rubberhelix/MultiSNICS_Interlock/Resources/Interlock Panel.png

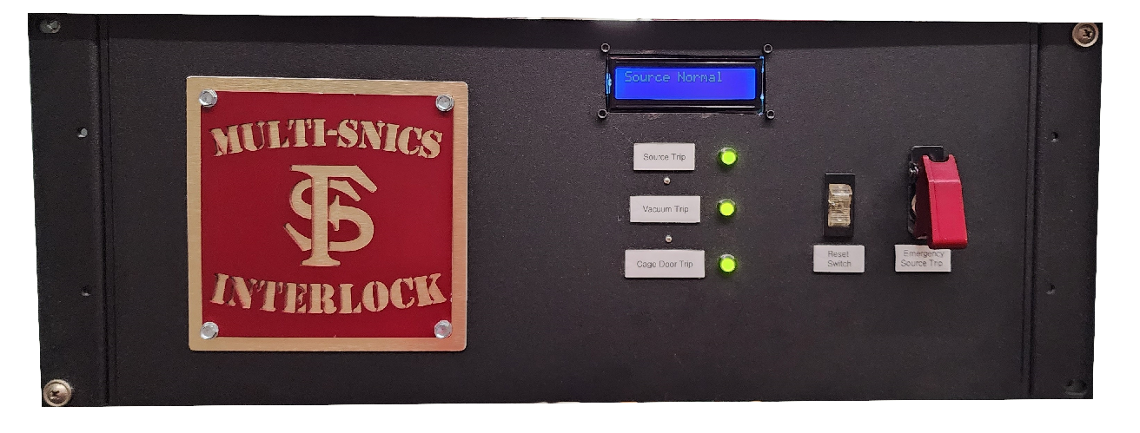
Resources/Interlock Panel.png
