rubberhelix/MultiSNICS_Interlock/Resources/Multi-SNICS Interlock User Manual Rev1.pdf

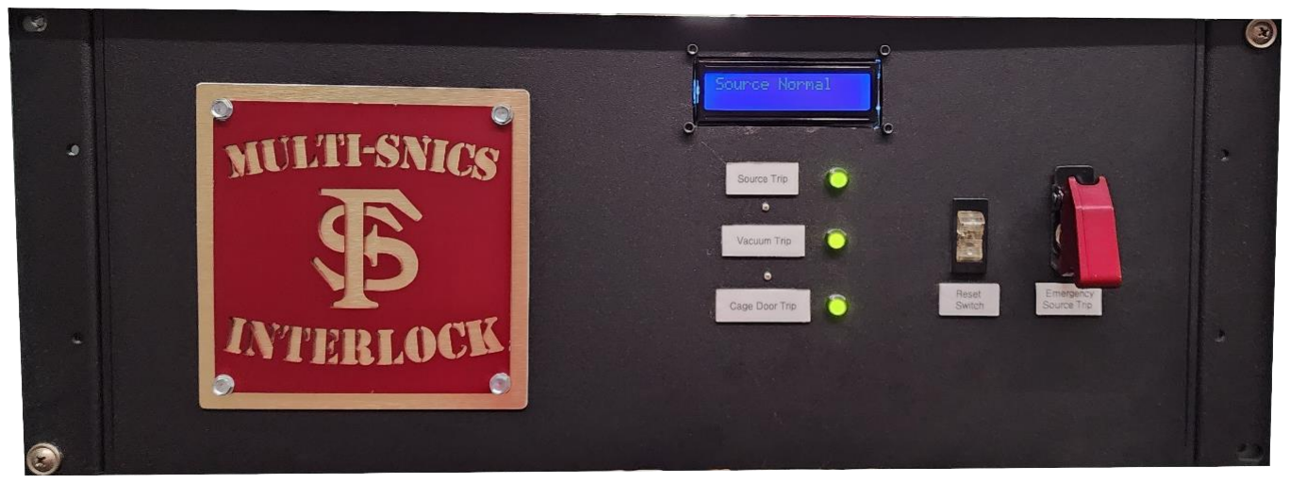
[picture p2: figure]

# MULTI-SNICS INTERLOCK

## USER MANUAL

WRITTEN BY: JONAH GIBBONS
JOHN D. FOX LABORATORY

### REVISION 1

MULTI-SNICS INTERLOCK | P A G E | 1

## SAFETY NOTICE

Please take a moment to read and understand the following user manual before using or reconfiguring this Interlock System.
The following general safety precautions must be observed during all phases of operation, service, and repair of this instrument. Failure to comply with these precautions or each subsystem manufacture’s intended use can result in damage, personnel injury or even death.
The protective features of this product may be impaired if it is used in a manner not specified in the operation instructions.
1. Operation by Trained Personnel:
The Interlock System must be operated and configured by qualified and trained personnel who are familiar with the electrical and ion accelerator systems.
2. Lockout/Tagout Procedures:
Before servicing the Interlock System, follow all applicable lockout/tagout procedures to ensure that controlled equipment is safely de-energized and secured to prevent inadvertent state changes that could cause damage, injury, or death.
3. Proper Cable Routing:
High voltage differences between the ground, mid-, and high potential areas can cause arcing electrical sparks. Ensure proper isolation and insulation provides adequate separation of conducting materials.
4. Regular Maintenance:
Regularly inspect the Interlock System for malfunctions. A basic set of test procedures is provided in this manual, but it is recommended to establish a general procedure for testing the Interlock System prior to, during, and after operating the ion accelerator.
5. Emergency Procedures:
Establish and communicate emergency shutdown procedures in case of any system failure or malfunction. Ensure that all personnel are aware of these procedures.
6. Restricted Access:
Restrict access and authority of the Interlock System's controls and components to authorized personnel only.
7. Environmental Considerations:
Do not expose the system to extreme temperatures, moisture, or corrosive environments. Adverse conditions can affect the system's performance.

8. Hazard Identification:
Clearly label all Interlock System control points and components to help users easily identify and understand their function.
9. Training:
Ensure that all personnel responsible for operating the ion accelerator or the Interlock System receive proper training on its operation and safety procedures.
10. Emergency Shutdown:
In case of an emergency, the Interlock System may be overridden or bypassed if required for safety reasons. Ensure that this process is well-documented and supervised. Operating the system in a bypassed state for periods extending beyond emergency conditions defeats the integrity and purpose of using an Interlock System and abiding by its established procedures. Bypassed conditions should be announced at every proceeding staff briefing to be sure the situation is not overlooked or forgotten until it is permanently resolved, and the bypass condition no longer exists.
11. High-power Danger:
The Interlock System controls several high-power supplies that operate the ion source. These power supplies can cause extreme injury or death. Beware of the risk involved and consult with laboratory staff to ensure the risks are always mitigated.
12. Radioactive Hazard:
The multi-SNICS is configured to use tritium cathodes. Tritium is radioactive and presents a health risk if you are exposed. Be sure you are briefed on the status of tritium inside the ion source and aware of the proper handling procedures to avoid a leak or release of tritium. If it is suspected that tritium has escaped containment. Immediately evacuate the room and report your concern to lab personnel.

### Table of Contents

# Overview

The Multi-SNICS has several very high voltage power supplies, a high vacuum chamber, several types of pumps, and is designed to work with tritium embedded cathodes. Tritium is a radioactive isotope of hydrogen that poses a significant health risk if ingested, inhaled, or absorbed into the body. To operate the Multi-SNICS safely, a comprehensive safety plan is required. Part of the plan is an Interlock System that acts as a fail-safe mechanism, actively monitoring key parameters such as closure of the cage doors surrounding the source, leaking tritium detection, vacuum pressure, building power, coolant flow, and smoke detection. In the event of deviations from safe operating conditions, the Interlock System initiates automatic shutdown procedures, preventing potential harm to personnel, the environment, and the equipment itself.

# Equipment

The Interlock System is based on a P1AM ProductivityOpen PLC controller. It has industrial grade ratings to endure harsh environments. There are a lot of options for modules that snap together and communicate on a Modbus. The expandability of this platform makes it a good choice for this application because it can evolve to meet new needs in the future. [Appendix E]

## ProductivityOpen Controller

The Interlock System uses the following P1AM series modules:

- P1AM-100 – Main CPU [Appendix F]
- P1-01DC – Modbus Power Supply [Appendix G]
- P1AM-ETH – Ethernet Shield [Appendix H]
- P1AM-GPIO – General Purpose Input/Output Shield [Appendix I]
- P1-16ND3 – 16 Discrete Inputs [Appendix J]
- P1-08TRS (2x) – 8 Relay Outputs [Appendix K]
- P1-04ADL-2 – 4 Analog Inputs [Appendix L]

## Main Power Supply

There is a Mean Well USA Inc AC/DC converter that converts 120 VAC to 24 VDC and is used to power everything in the rack-mounted enclosure.

## Fiber Optic Isolation

The ion source has two high-voltage regions that must be electrically isolated to prevent a short circuit. The regions are each referred to as the high and mid-potential regions respective of their relative voltage potential. Each region has a fiber optic link to relay contact closures or analog signals between the Interlock System and the sensors and control devices. [Appendix M,N]

### -Interlock System Enclosure (Ground Potential):

- 2x Bidirectional contact closure fiber transceivers
- Analog voltage signal fiber receiver

### -Mid-potential Area:

- Bidirectional contact closure fiber transceiver
- Analog voltage signal fiber transmitter

### -High-potential Area:

- Bidirectional contact closure fiber transceiver

## LCD Screen

The screen is a commonly used 1602 LCD module with a built in HD44780 controller. It can display 2 lines of up to 16 characters. It receives display commands from the P1AM-GPIO shield.
*** It requires 5 VDC power but must have a common ground with the P1AM Modbus. Accessing the Modbus common was difficult and required modifying the GPIO shield by opening the case and soldering a wire to a through-via that connected to the Modbus common.***

## Sensors

- Cage door contacts
- Fume hood flow switch
- Vacuum gauge threshold relays
- Vacuum gauge analog output [Appendix O]
- Tritium detector threshold relay
- Tritium detector analog output
- Building power monitor relay
- Coolant flow switches
- Smoke detector [Appendix Q]
- Titanium sublimation pump analog output [Appendix P]

# Specifications

Interlock System Enclosure | 120 VAC
Enclosure DC Power Supply | 24 VDC
Bidirectional Fiber Transceivers | 120 VAC
Fiber Mode | Single mode
Analog Signal Fiber Transmitter/Receiver | 24 VDC
Analog Signal Voltage Range | 0-10 VDC
Fiber Mode | Multi mode
P1-16ND3 Module Input Rating | 12-24 VDC sink/source
P1-04ADL-2 Analog Module | 0-10 VDC signals
Resolution | 13-bit
Cage Door Contacts | Normally Closed
Fume Hood Flow Switch | Normally Closed
Vacuum Condition Relays | Normally Open
Analog Signal | 0-10 VDC
Tritium Monitor Relay | Normally Closed
Analog Signal | 0-10 VDC
Building Power Monitor Relay | Normally Closed
Coolant Flow Switches | Normally Closed
Smoke Detector | Normally Open
Sublimation Pump Analog Signal | 0-10 VDC

# Firmware

There is drag-and-drop, ladder logic, style programming software called Productivity Blocks, but it is also compatible with the Arduino development environment and can be programmed using C++. There is a micro-USB port on the P1AM-100 controller that is used to upload firmware and read serial output.

## File Structure

### interlock.ino

This is the main file for the software. It contains boot up procedures, main routines and any diagnostic functions for development and testing.

### states.ino

This file contains the settings for the output conditions for different states.

### tasks.ino

This file contains the main functions for checking the inputs, changing states, and updating interfaces.

### web.ino

This file contains the html code for the webpage served by the ethernet module. The webpage shows the state and conditions of the inputs as well as the analog values.

### diagnostics.ino

This file contains diagnostic functions and statements that can be copied into the main file or called from here if you un-comment them.

### map.h

This file contains the names for the signals and maps the ports and pins to convenient variable names (in# or out#). Only change the comments for the signals to match what's connected to the interlock for reference.

### config.h

This file contains the settings for the ethernet module, GPIO pins for the LCD screen, the states, the data structure, the normal conditions for the inputs, the alarm priority they are associated with, the Modbus modules, and the text strings used for the LCD display.

# Diagnostics

The primary diagnostic tool for the Interlock System is the serial output which can be read by connecting a laptop to the micro-USB port on the P1AM-100. There is also a switch next to the port which enables a periodic report of the interlock state and any of the inputs that are tripped. When the controller first boots up, the heartbeat LED flashes while it waits for initialization to finish. Then it checks the Modbus to verify all the modules are reporting. Every full cycle of the controller loop has a heartbeat of three flashes of the LED on the P1AM-100. There is also a watchdog timer which will automatically reset the controller if it takes longer than 5 seconds to complete a loop.

There is a diagnostics file in the firmware package which has some tools for diagnosing problems. In the file is a library called ArduinoTrace which has two useful functions for diagnosing firmware problems line by line. Reading the code and the comment lines can give a better clue as to the expected behavior of the Interlock System. Using the TRACE() and DUMP() functions provided by the ArduinoTrace library allow you to put markers in the code and dump variable data to the serial output so it is more easy to follow the program’s behavior.

The ethernet shield has a webpage server that provides a graphical display of the system state. It is set to automatically refresh every few seconds. This was designed to be a secondary display to provide information remotely to any computer which is connected to the lab’s local area network.

# Sample Test Procedure

A test procedure should be thorough and standardized. Starting with a list of the sensors, one method would be to test each of the sensors in order to verify that they are reporting the appropriate alarm. Verify that when they are tripped, the Interlock System responds with a buzzer alarm, an LED showing the trouble state, and the LCD showing the proper message. Then inducing a lower-level cage door trouble condition followed by a vacuum system trouble condition and a source trouble condition to demonstrate that the Interlock System escalates to higher trouble conditions when additional sensors are tripped. After each alarm, verify that the appropriate systems have been disabled and locked out in response to the trouble condition.

Cage door contacts | Test by opening the cage doors
Fume hood flow switch | Test by turning off the breaker in the electrical closet two stories above the lab
Vacuum gauge threshold relays | Test by changing the vacuum threshold level or by running the sublimation pump
Vacuum gauge analog output | Run the sublimation pump or cross check with other gauges nearby in the line
Tritium detector threshold relay | Change the calibration zero or use a test method prescribed in the manual
Tritium detector analog output | Change the calibration zero or use a test method prescribed in the manual
Building power monitor relay | Open the breaker located in the rack cabinet under the Interlock System enclosure
Coolant flow switches | Turn off the coolant pump
Smoke detector | Press the test button located on the smoke detector
Titanium sublimation pump analog output | Turn on the pump and cross check the current shown on the controller with the current measured by the analog output

## Appendix A: LED and Buzzer Wiring Diagram

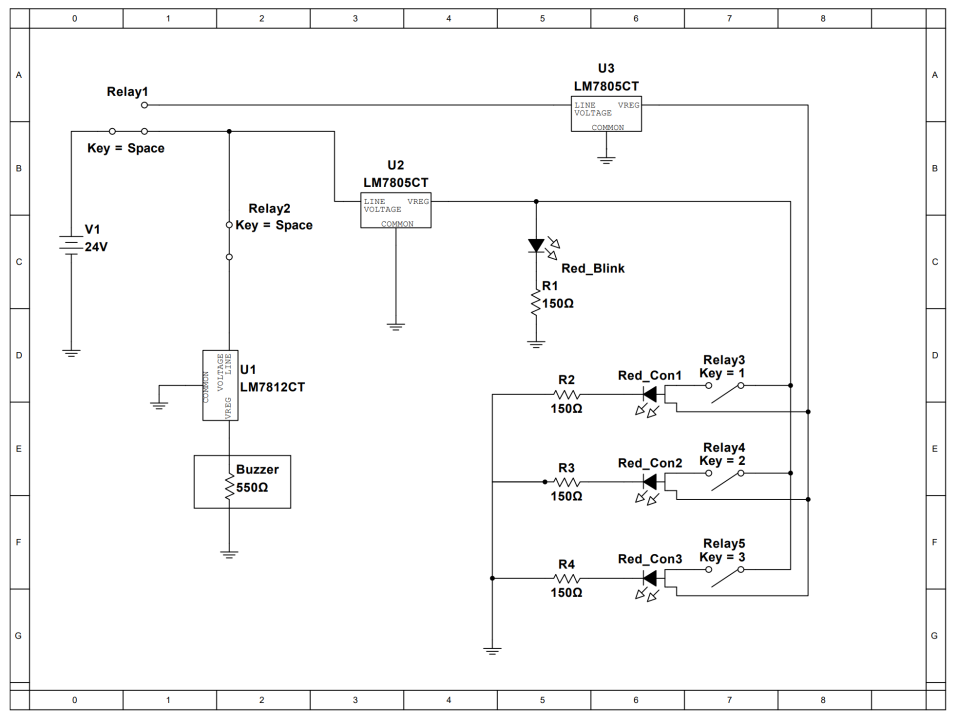
[picture p3: figure]

## Appendix B: Multi-SNICS Diagram

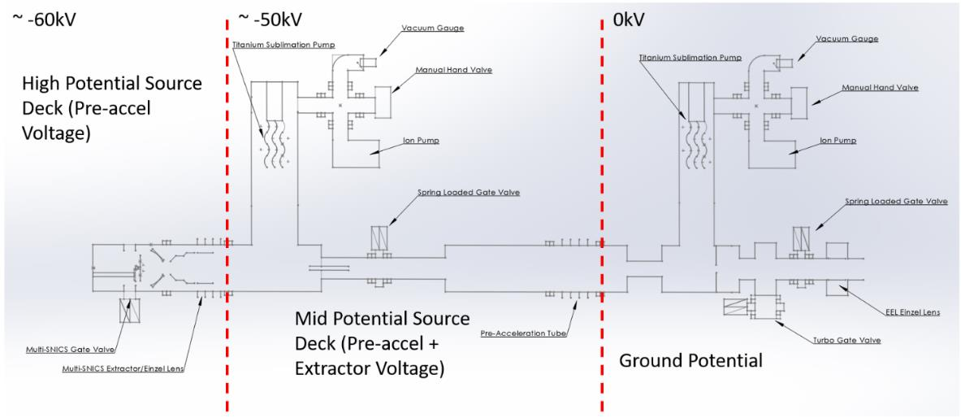
[picture p4: figure]

# Appendix C: Port Map

| Logic Port | Name | Wire Terminal | Normal State
Input: | 1.1 | Reset Button | - | NO
| 1.2 | Emergency Interlock Switch | - | NC
| 1.3 | Cage Door Sensor | Main 1 | NC
| 1.4 | Fume Hood Flow Switch | Main 2 | NC
| 1.5 | Vacuum Condition 2 - Ground | Main 3 | NO
| 1.6 | Tritium Monitor Relay | Main 4 | NC
| 1.7 | (UNUSED) | - | -
| 1.8 | Building Power Failure Relay | Main 6 | NC
| 1.9 | Coolant Flow Switch 2 - Ground | Main 7 | NC
| 1.10 | Vacuum Condition 1 - Mid Potential | Fiber K9 - Mid | NO
| 1.11 | (UNUSED) | - | -
| 1.12 | Coolant Flow Switch 1 - Mid Potential | Fiber K9 - High | NC
| 1.13 | Smoke Detector - High Potential | Fiber K10 - High | NO
| 1.14 | (UNUSED) | - | -
| 1.15 | (UNUSED) | - | -
| 1.16 | (UNUSED) | - | -
(analog) | Tritium Sniffer - Ground | Main 17 & 18
(analog) | Vacuum Gauge - Mid Potential | Fiber - Mid
(analog) | Sublimation Pump - Mid Potential | Fiber - Mid
Output: | 2.1 | Green and Flashing Red LEDs | -
| 2.2 | Buzzer | -
| 2.3 | Red LED Trouble 1 | -
| 2.4 | Red LED Trouble 2 | -
| 2.5 | Red LED Trouble 3 | -
| 2.6 | Pre-accelerator Power Supply | Main 9 & 10
| 2.7 | Gate Valve - Ground | Main 11 & 12
| 2.8 | Gate Valve - Mid Potential | Fiber K1 - Mid
3.1 | | -
3.2 | | -
3.3 | | -
3.4 | | -
3.5 | | -
3.6 | High-volt Power Supplies | Fiber K1 - High
3.7 | Boiler | Fiber K2 - High
3.8 | Ionizer | Fiber K3 - High

## Appendix D: Trouble Modes

| Low Cage Door Trip | Medium Vacuum Trip | High Source Trip
| (Trouble 1) | (Trouble 2) | (Trouble 3)
Outputs | Pre-accelerator Supply Off | Pre-Accelerator Supply Off | Pre-Accelerator Supply Off
| Other High-Power Supplies Off | Other High-Power Supplies Off | Other High-Power Supplies Off
| | Both Gate Valves Closed | Close Both Gate Valves
| | Ionizer | Boiler
| | | Ionizer
Inputs | Cage Door Contact | Vacuum Condition (Gnd) | Emergency Source Trip Switch
| | Vacuum Condition (Mid) | Fume Hood Flow Switch
| | | Tritium Monitor Relay
| | | Building Power Failure Relay
| | | Smoke Detector

## Appendix E: Interlock System Enclosure

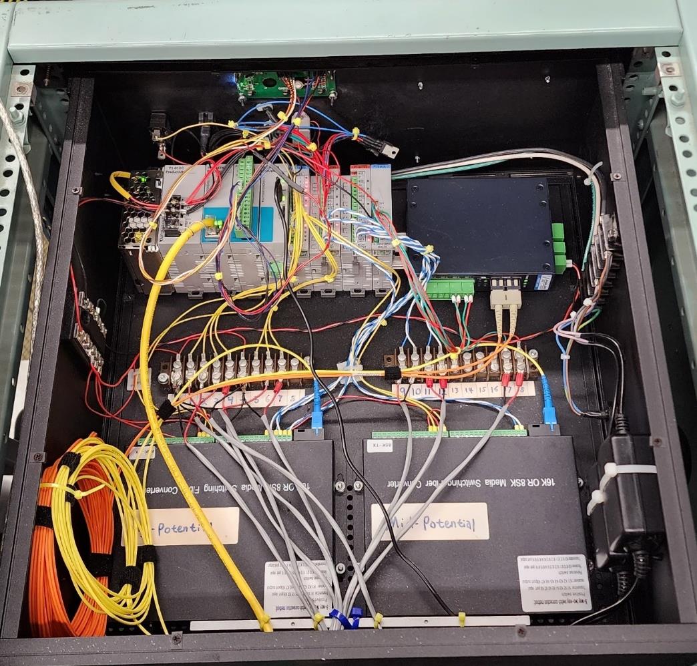
[picture p5: figure]

## Appendix F: P1AM-100 Product Description

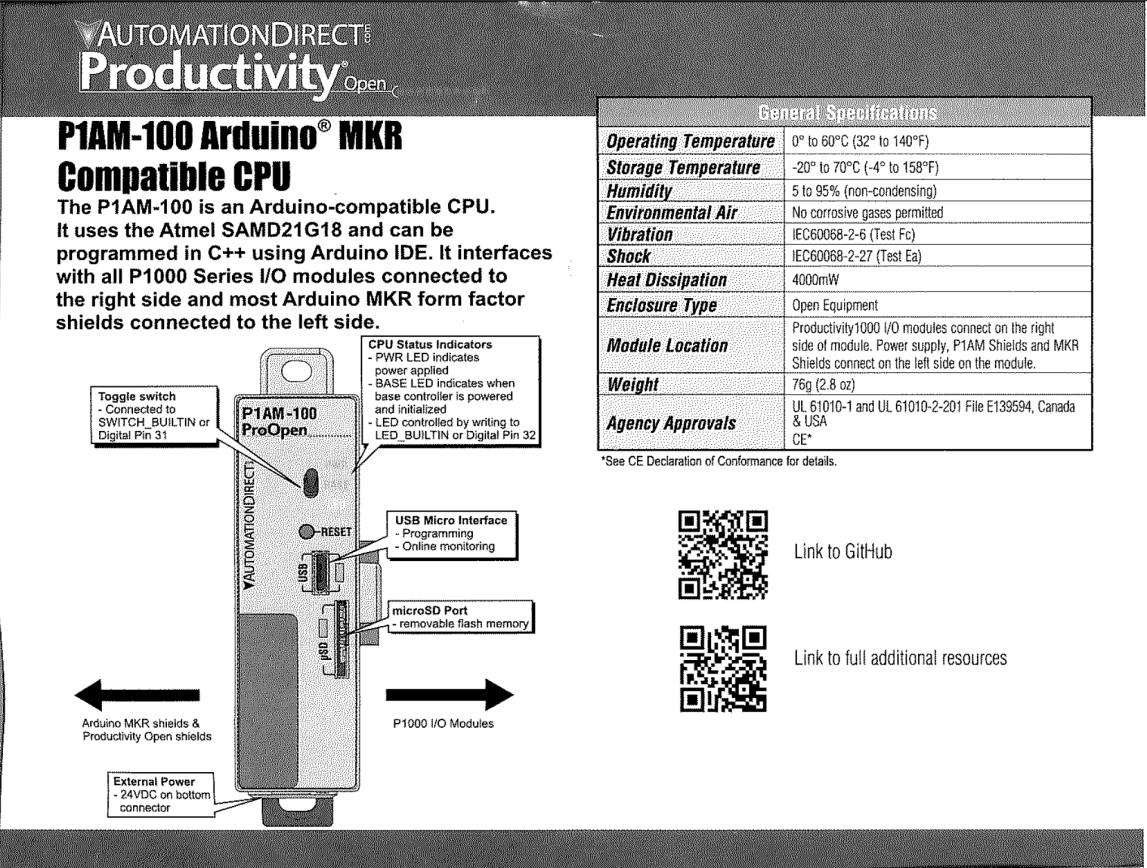
[picture p6: figure]

## Appendix G: P1-01DC Product Description

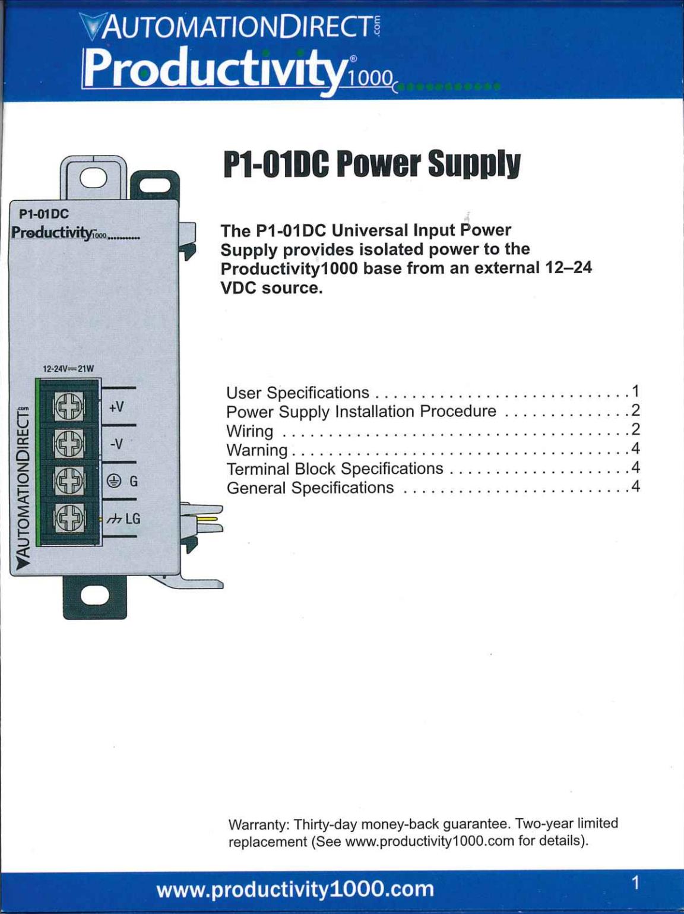
[picture p7: figure]

## Appendix H: P1AM-ETH Product Description

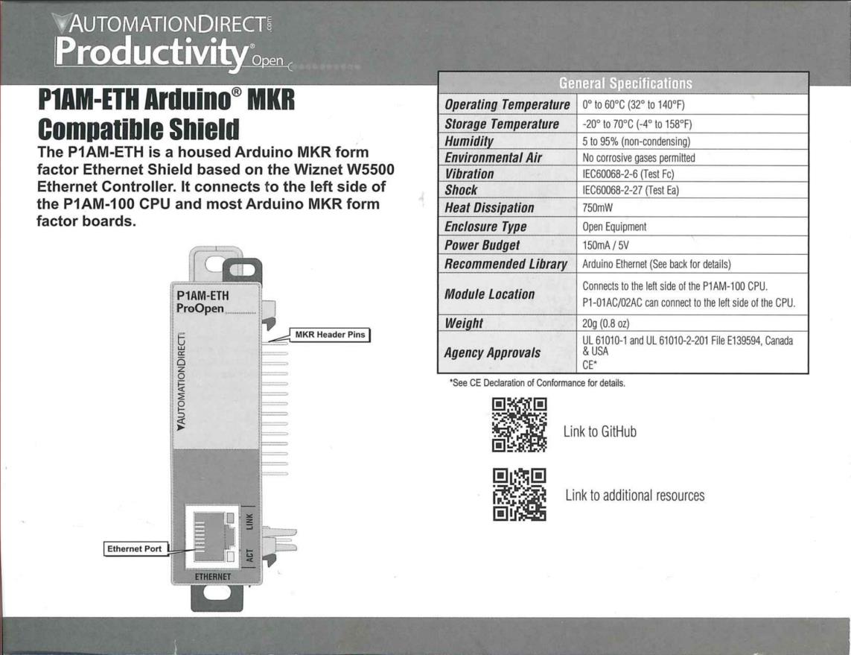
[picture p8: figure]

## Appendix I: P1AM-GPIO Product Description

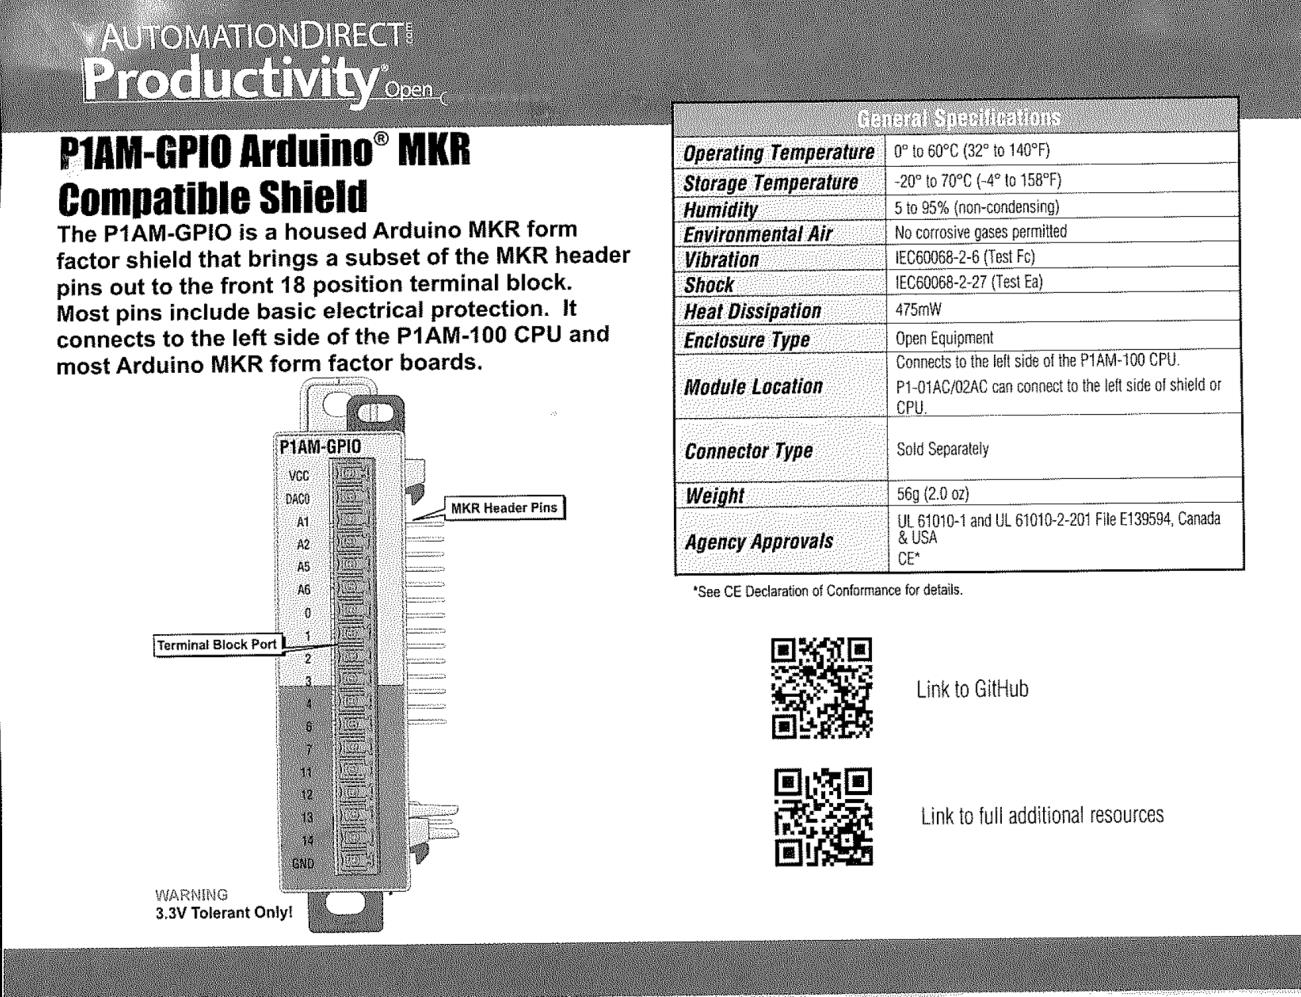
[picture p9: figure]

## Appendix J: P1-16ND3 Product Description

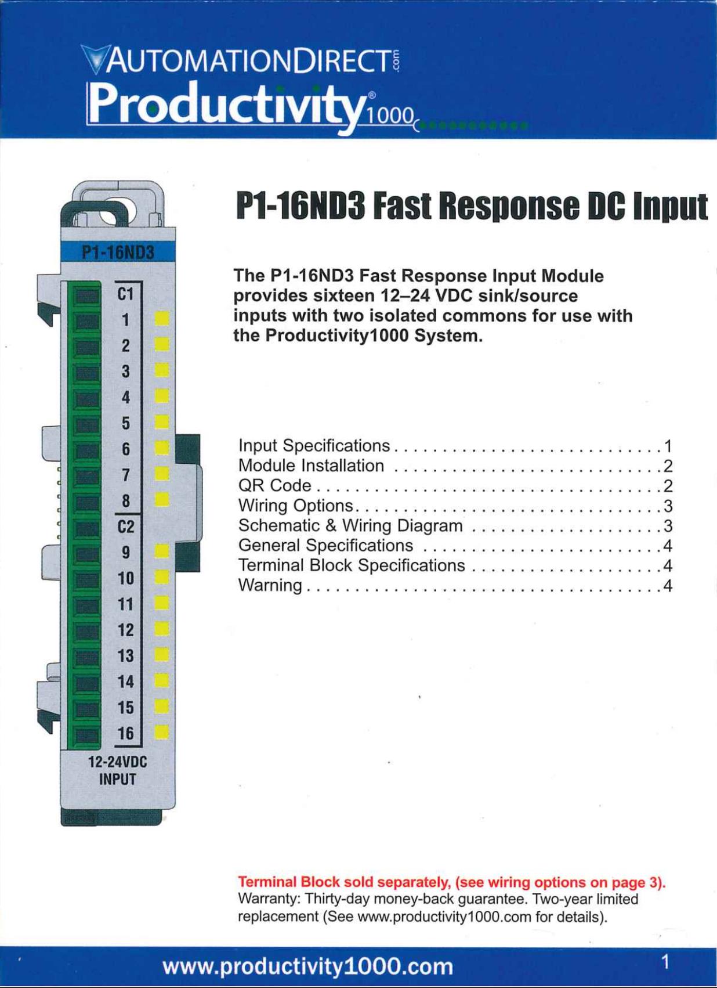
[picture p10: figure]

## Appendix K: P1-08TRS Product Description

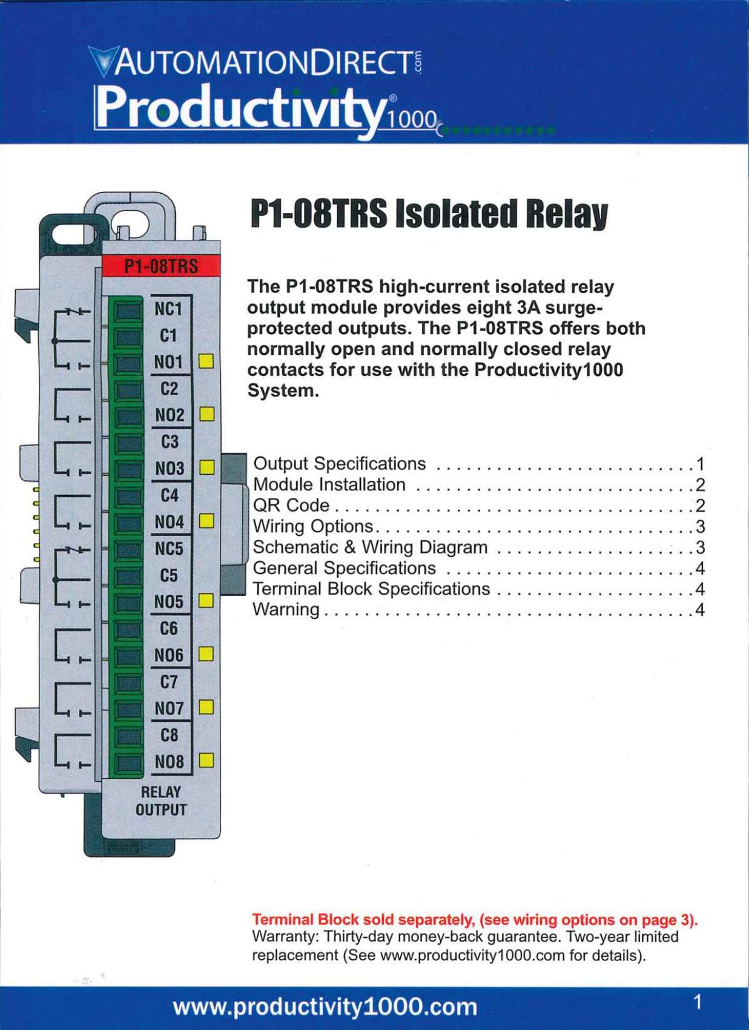
[picture p11: figure]

## Appendix L: P1-04ADL Product Description

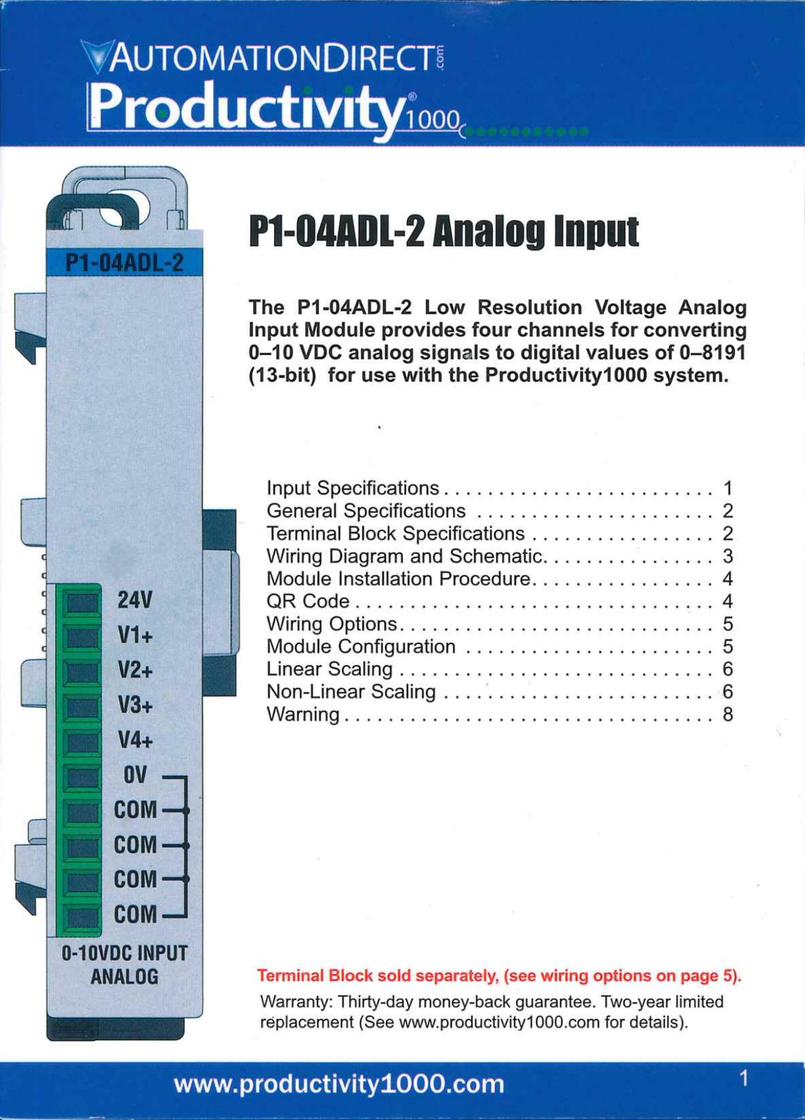
[picture p12: figure]

## Appendix M: ADH-010TX/RX-03-1 Analog Fiber Link Information

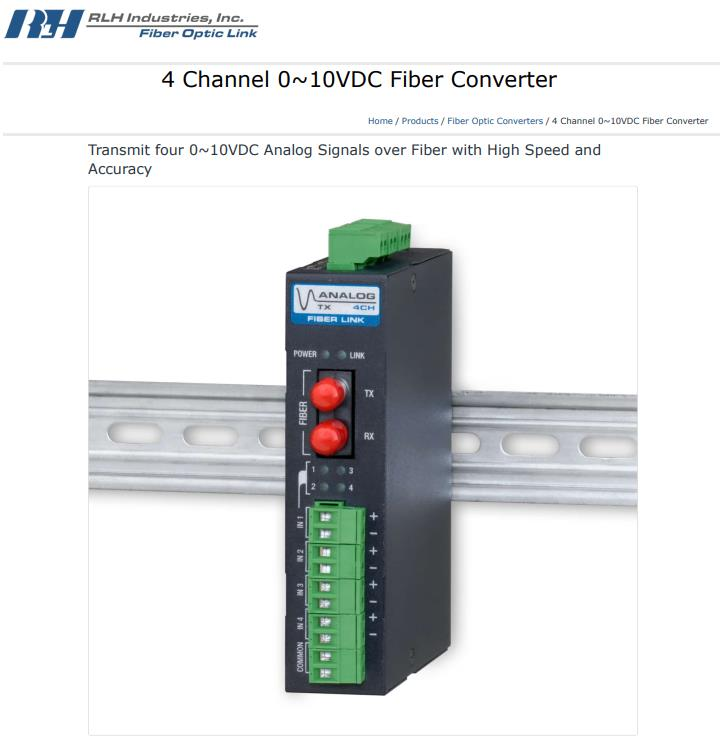
[picture p13: figure]

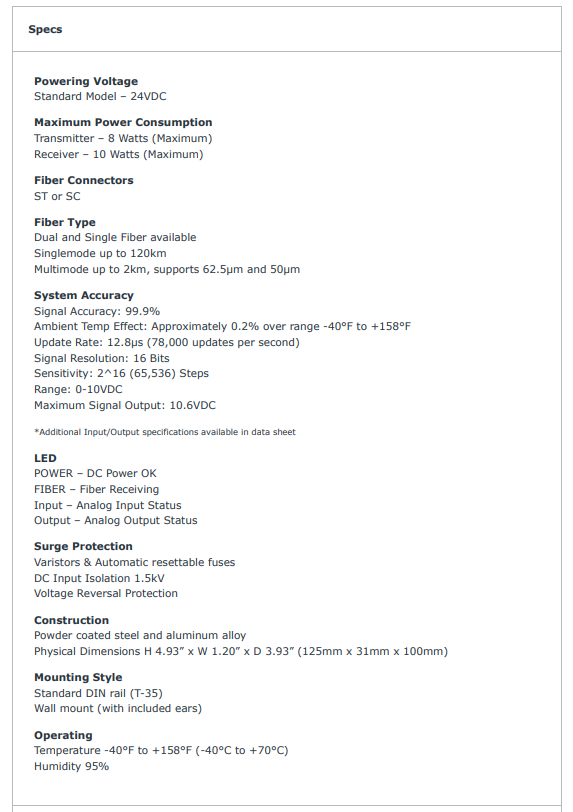
[picture p14: figure]

## Appendix N: Bidirectional Fiber Link Information

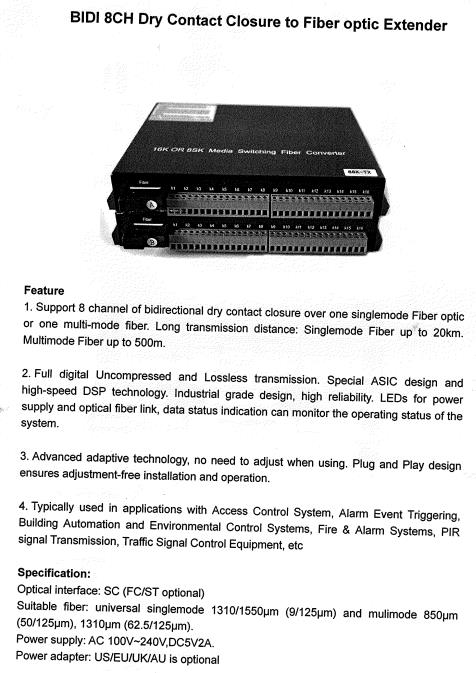
[picture p15: figure]

## Appendix O: AGC302 Vacuum Gauge Controller Connection

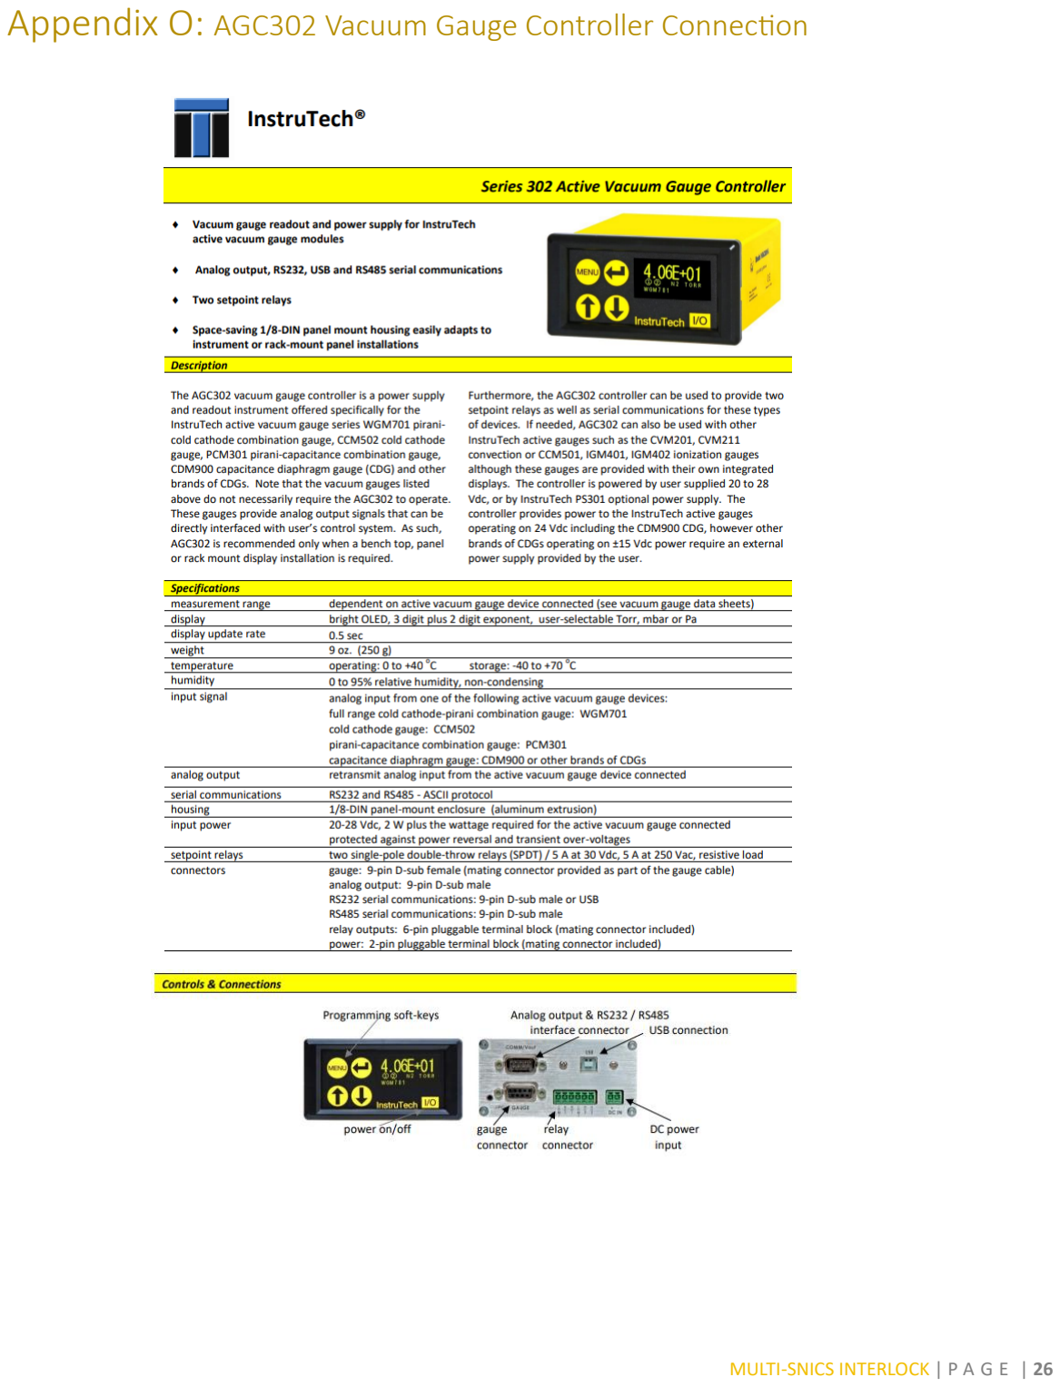
[picture p16: page 27]

## Appendix P: Titanium Sublimation Pump Connection

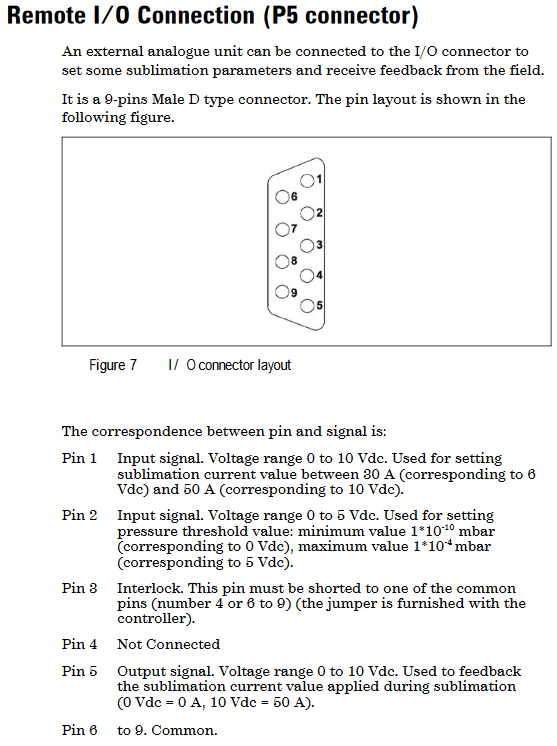
[picture p17: figure]

## Appendix Q: Smoke Detector Information

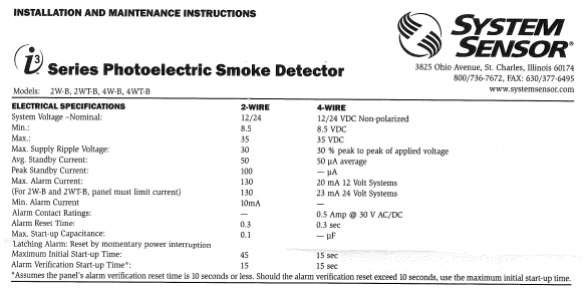
[picture p18: figure]
